MohamedSharfi/Smart-Parking-System/(list of files, drawings)

Other design files:
S_proteus_Simulation/New Project.pdsprj
S_proteus_Simulation/parkingsystem.pdsprj
S_proteus_Simulation/Project Backups/New Project [20240118, 03-53-10].pdsprj
S_proteus_Simulation/Project Backups/New Project [20240118, 22-47-52].pdsprj
S_proteus_Simulation/Project Backups/New Project [20240122, 00-21-29].pdsprj
S_proteus_Simulation/Project Backups/parkingsystem [20231211, 16-15-26].pdsprj
S_proteus_Simulation/Project Backups/parkingsystem [20231211, 16-15-28].pdsprj
S_proteus_Simulation/Project Backups/parkingsystem [20231211, 16-28-50].pdsprj
S_proteus_Simulation/Project Backups/parkingsystem [20231211, 16-30-04].pdsprj
S_proteus_Simulation/Project Backups/parkingsystem [20231211, 16-30-06].pdsprj
S_proteus_Simulation/Project Backups/parkingsystem [20231211, 16-30-09].pdsprj
S_proteus_Simulation/Project Backups/parkingsystem.pdsprj
S_proteus_Simulation/Project Backups/Project Backups/parkingsystem [20231211, 17-00-00].pdsprj
S_proteus_Simulation/Project Backups/Project Backups/parkingsystem [20231211, 20-50-02].pdsprj
S_proteus_Simulation/Project Backups/Project Backups/parkingsystem [20231213, 11-20-48].pdsprj
S_proteus_Simulation/Project Backups/Project Backups/parkingsystem [20231213, 11-32-14].pdsprj
S_proteus_Simulation/Project Backups/Project Backups/parkingsystem [20231213, 11-32-15].pdsprj
S_proteus_Simulation/Project Backups/Project Backups/parkingsystem [20231213, 12-07-39].pdsprj
S_proteus_Simulation/Project Backups/Project Backups/parkingsystem [20231213, 15-48-10].pdsprj
S_proteus_Simulation/Project Backups/Project Backups/parkingsystem [20231214, 19-26-32].pdsprj
S_proteus_Simulation/Project Backups/Project Backups/parkingsystem [20231214, 19-26-35].pdsprj
S_proteus_Simulation/Project Backups/Project Backups/parkingsystem [20231214, 20-07-07].pdsprj
